gaoDean/eink/README.md

Screenshot 2026-08-07 at 11 20 23 PM
