gaoDean/eink/sims/led.asc

GREEN: LED; NSCW100
M1: nmos; BSS145
ORANGE: LED; NSCW100
R1: res; {R_val}
R2: res; 1K
R3: res; 100K
R4: res; 1K
V1: voltage; 5
Named nets: 0
.step param R_val list 1 1k 5k 10k 50k 100k
.op
