gaoDean/eink/sims/power path.asc

C1: cap; 4.7µ; V=10 Irms=0 Rser=4 Lser=0 mfg="AVX" pn="TAJB475M010" type="Tantalum"
C2: cap; 22µ; V=16 Irms=0 Rser=1.6 Lser=0 mfg="AVX" pn="TAJC226K016" type="Tantalum"
C3: cap; 1µ; V=16 Irms=0 Rser=11 Lser=0
D1: schottky; MBRS140
M1: pmos; AO3423
R1: res; 100K; tol=1 pwr=0.1
R2: res; 100R
R3: res; 10K; tol=1 pwr=0.1
V1: voltage; 3.7
V2: voltage; PWL(0 0 0.01 5)
Named nets: 0
.tran 0.02
