gaoDean/eink/sims/reverse polarity.asc

M1: pmos; AO6407
R1: res; 100k
R2: res; 100R
V1: voltage; PWL(0 4.2 2 -4.2)
Named nets: 0
.tran 2
