gaoDean/eink/eink.kicad_pcb

## KiCad design eink.kicad_pcb (2026-08-09)

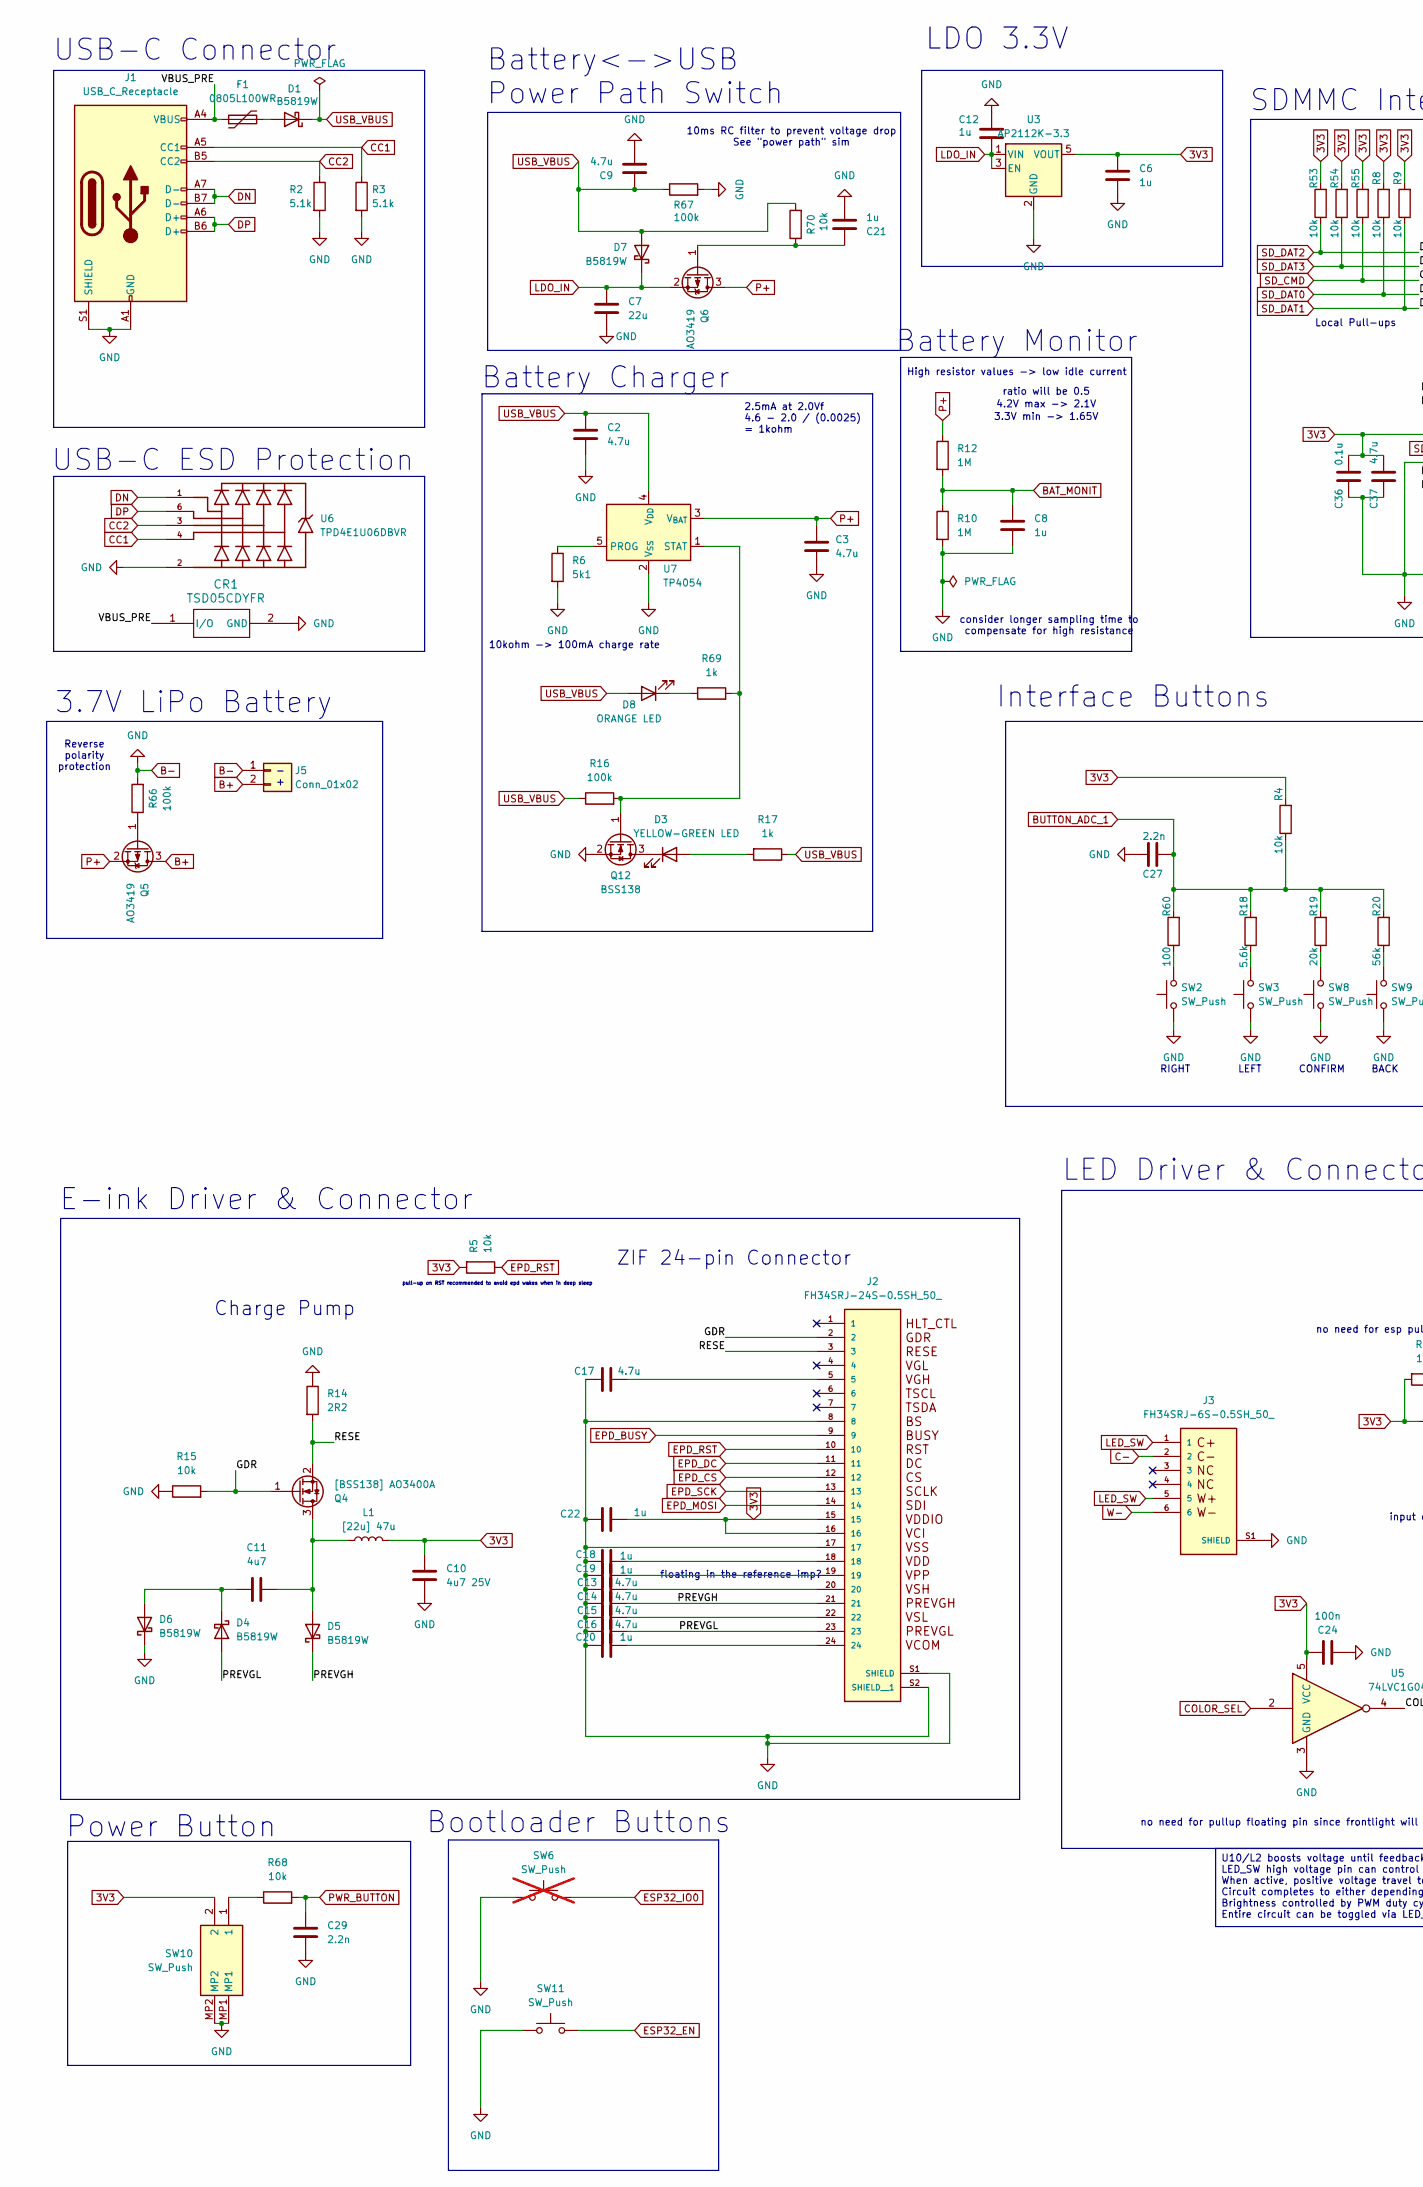
[picture p1: schematic eink.kicad_sch, part in row 1, column 1]

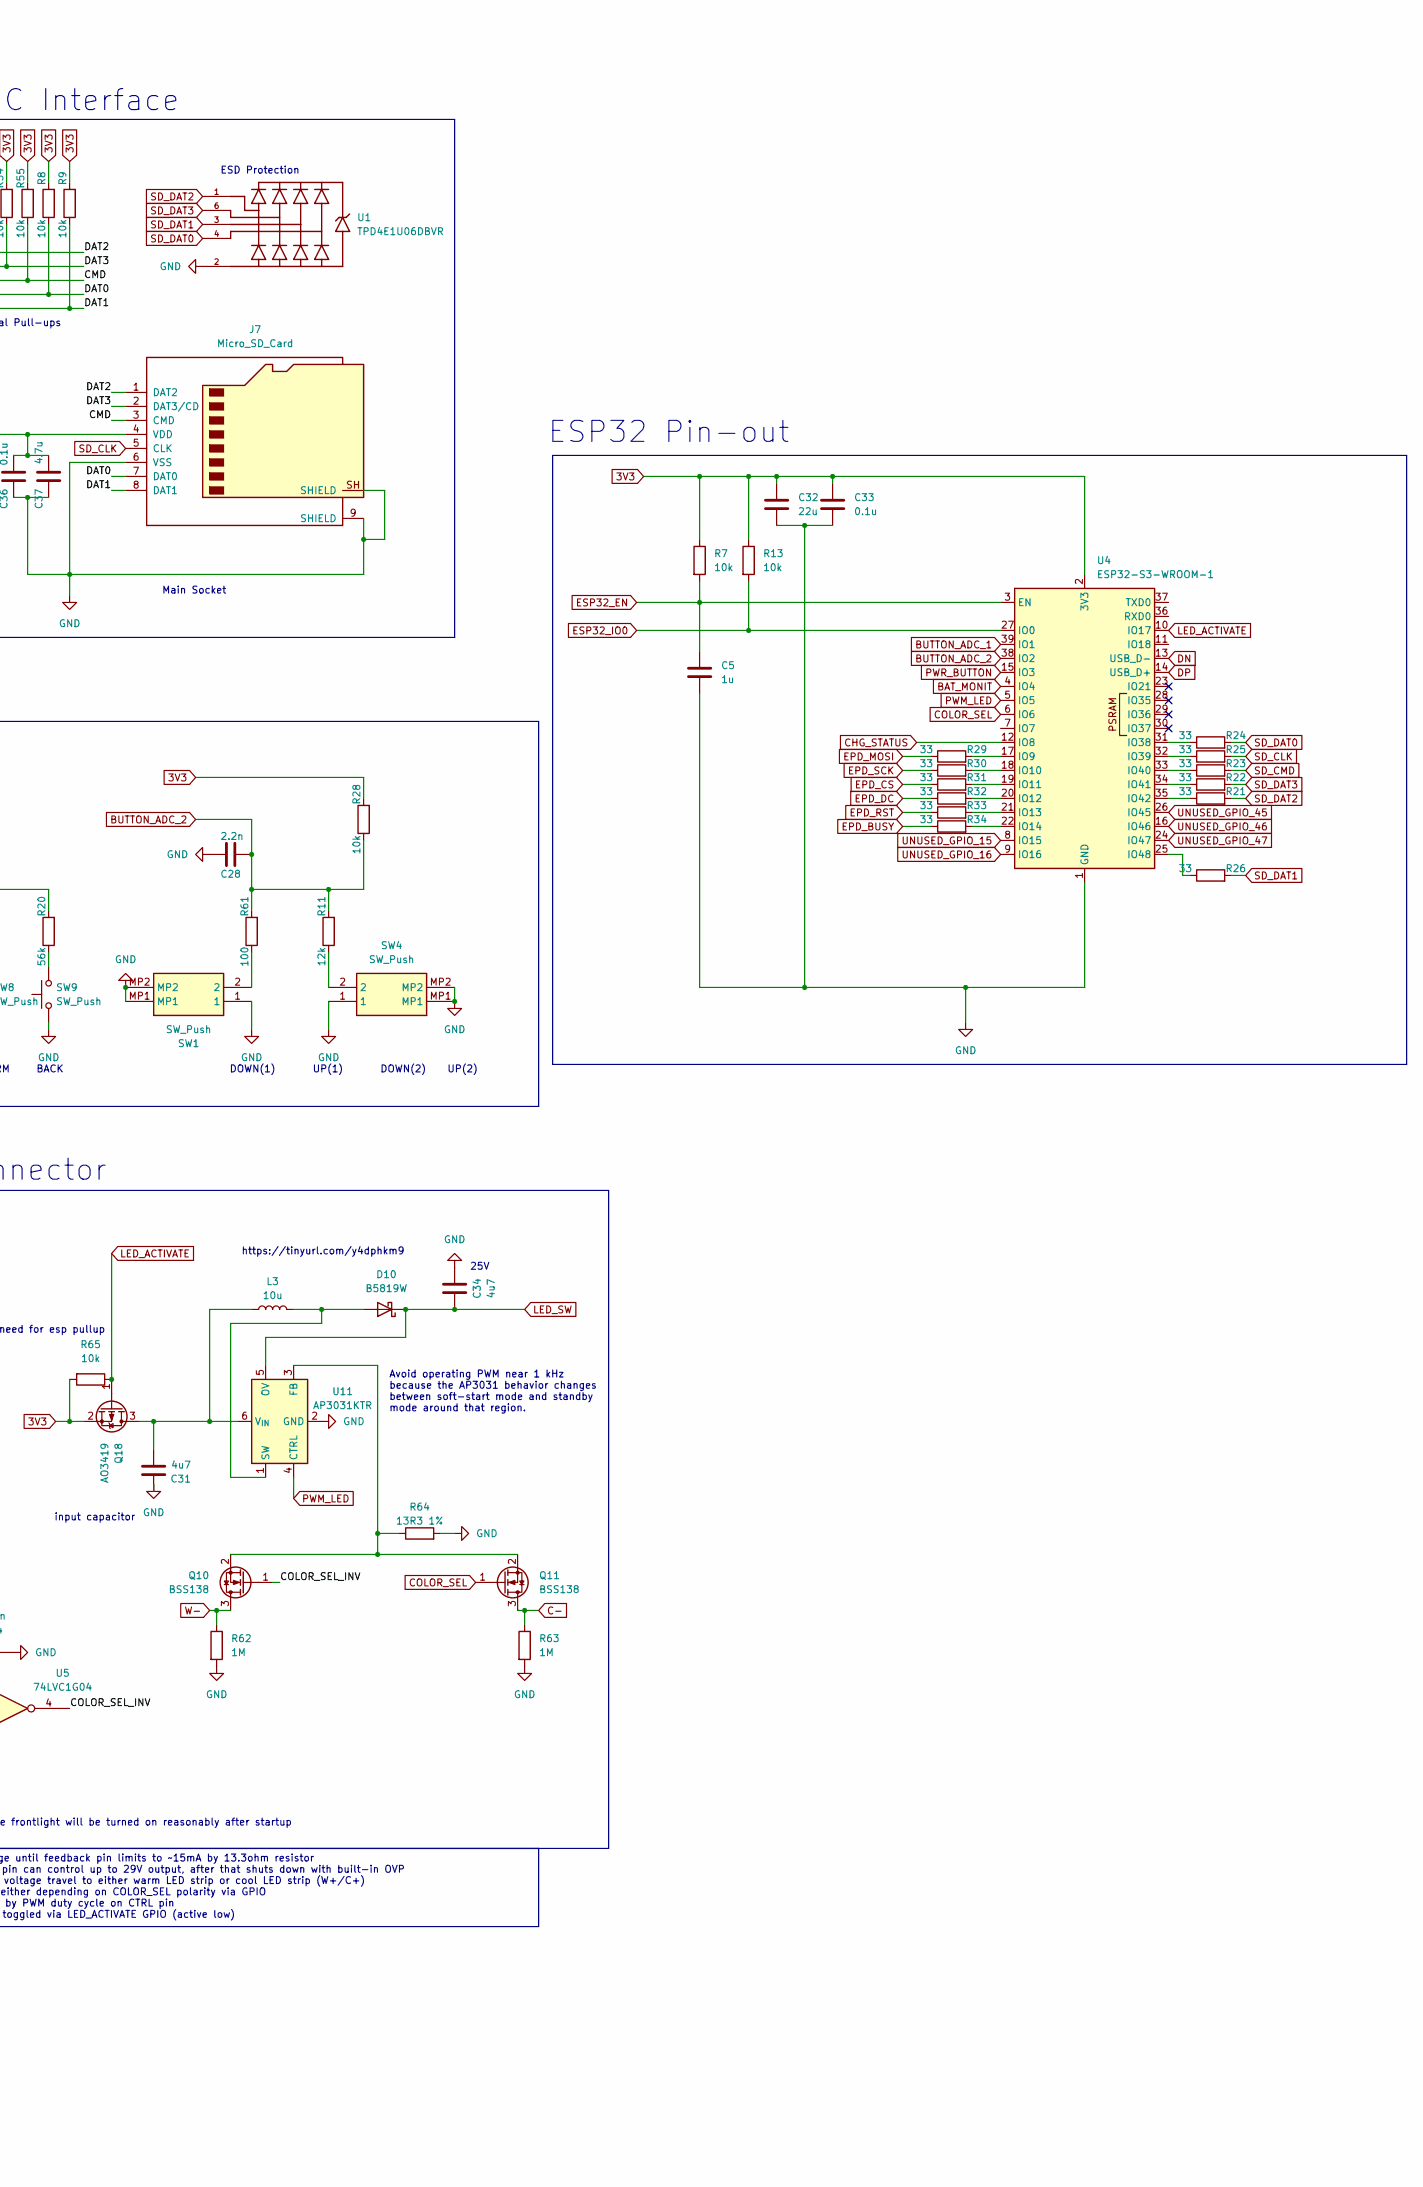
[picture p2: schematic eink.kicad_sch, part in row 1, column 2]

Parts:
C2, C3, C9, C13, C14, C15, C16, C17, C37: 4.7u; C_0805_2012Metric_Pad1.18x1.45mm_HandSolder
C5, C6, C8, C12, C18, C19, C20, C21, C22: 1u; C_0805_2012Metric_Pad1.18x1.45mm_HandSolder
C7, C32: 22u; C_0805_2012Metric_Pad1.18x1.45mm_HandSolder
C10: 4u7 25V; C_0805_2012Metric_Pad1.18x1.45mm_HandSolder
C11, C31, C34: 4u7; C_0805_2012Metric_Pad1.18x1.45mm_HandSolder
C24: 100n; C_0805_2012Metric_Pad1.18x1.45mm_HandSolder
C27, C28, C29: 2.2n; C_0805_2012Metric_Pad1.18x1.45mm_HandSolder
C33, C36: 0.1u; C_0805_2012Metric_Pad1.18x1.45mm_HandSolder
CR1: TSD05CDYFR; D_SOD-323_HandSoldering
D1, D4, D5, D6, D7, D10: B5819W; D_SOD-123
D3: YELLOW-GREEN LED; LED_0805_2012Metric_Pad1.15x1.40mm_HandSolder
D8: ORANGE LED; LED_0805_2012Metric_Pad1.15x1.40mm_HandSolder
F1: 0805L100WR; Fuse_0805_2012Metric_Pad1.15x1.40mm_HandSolder
J1: USB_C_Receptacle; USB_C_Receptacle_TYPE-C-16P-CB1-6-073
J2: FH34SRJ-24S-0.5SH_50_; HRS_FH34SRJ-24S-0.5SH_50_
J3: FH34SRJ-6S-0.5SH_50_; HRS_FH34SRJ-6S-0.5SH_50_; DigiKey_Part_Number H125773CT-ND
J5: Conn_01x02; Battery pads
J7: Micro_SD_Card; microSD_HC_Hirose_DM3AT-SF-PEJM5
L1: [22u] 47u; IND_SRN3010C-100M
L3: 10u; IND_SRN3010C-100M
Q4: [BSS138] AO3400A; SOT-23
Q5, Q6, Q18: AO3419; SOT-23_Handsoldering
Q10, Q11, Q12: BSS138; SOT-23
R2, R3: 5.1k; R_0805_2012Metric_Pad1.20x1.40mm_HandSolder
R4, R5, R7, R8, R9, R13, R15, R28, R53, R54, R55, R65, R68, R70: 10k; R_0805_2012Metric_Pad1.20x1.40mm_HandSolder
R6: 5k1; R_0805_2012Metric_Pad1.20x1.40mm_HandSolder
R10, R12, R62, R63: 1M; R_0805_2012Metric_Pad1.20x1.40mm_HandSolder
R11: 12k; R_0805_2012Metric_Pad1.20x1.40mm_HandSolder
R14: 2R2; R_0805_2012Metric_Pad1.20x1.40mm_HandSolder
R16, R66, R67: 100k; R_0805_2012Metric_Pad1.20x1.40mm_HandSolder
R17, R69: 1k; R_0805_2012Metric_Pad1.20x1.40mm_HandSolder
R18: 5.6k; R_0805_2012Metric_Pad1.20x1.40mm_HandSolder
R19: 20k; R_0805_2012Metric_Pad1.20x1.40mm_HandSolder
R20: 56k; R_0805_2012Metric_Pad1.20x1.40mm_HandSolder
R21, R22, R23, R24, R25, R26, R29, R30, R31, R32, R33, R34: 33; R_0805_2012Metric_Pad1.20x1.40mm_HandSolder
R60, R61: 100; R_0805_2012Metric_Pad1.20x1.40mm_HandSolder
R64: 13R3 1%; R_0805_2012Metric_Pad1.20x1.40mm_HandSolder
SW1, SW4, SW10: SW_Push; SKSNLAE010; Mouser Part Number 688-SKSNLAE010
SW2, SW3, SW8, SW9: SW_Push; SKQGABE010_ALPS_Reverse
SW6: SW_Push; TestPoint_Bridge_Pitch2.54mm_Drill1.0mm; not fitted
SW11: SW_Push; TestPoint_Bridge_Pitch2.54mm_Drill1.0mm
U1, U6: TPD4E1U06DBVR; SOT-23-6_Handsoldering; PARTREV D; DigiKey_Part_Number 296-35965-1-ND
U3: AP2112K-3.3; SOT-23-5_HandSoldering
U4: ESP32-S3-WROOM-1
U5: 74LVC1G04; SOT-23-5_HandSoldering
U7: TP4054; SOT-23-5
U11: AP3031KTR; SOT-23-6_Handsoldering

Connections:
3V3: C6.1, C10.2, C22.2, C24.1, C32.1, C33.1, C36.2, C37.2, J2.15, J2.16, J7.4 (VDD), L1.2, Q18.2 (S), R4.2, R5.2, R7.1, R8.2, R9.2, R13.1, R28.2, R53.2, R54.2, R55.2, R65.2, SW10.2, U3.5 (VOUT), U4.2 (3V3), U5.5 (VCC)
/COLOR_SEL_INV: Q10.1 (G), U5.4
/GDR: J2.2, Q4.1 (G), R15.2
/PREVGH: C14.2, D5.1 (K), J2.21
/PREVGL: C16.2, D4.2 (A), J2.23
/RESE: J2.3, Q4.2 (S), R14.2
/VBUS_PRE: CR1.1 (I/O), F1.1, J1.A4 (VBUS), J1.A9 (VBUS), J1.B4 (VBUS), J1.B9 (VBUS)
B+: J5.2, Q5.3 (D)
B-: C2.2, C3.2, C5.2, C6.2, C7.2, C8.2, C9.2, C10.1, C12.2, C13.1, C14.1, C15.1, C16.1, C17.1, C18.1, C19.1, C20.1, C21.2, C22.1, C24.2, C27.1, C28.1, C29.2, C31.1, C32.2, C33.2, C34.1, C36.1, C37.1, CR1.2 (GND), D6.1 (K), J1.A1 (GND), J1.A12 (GND), J1.B1 (GND), J1.B12 (GND), J1.S1 (SHIELD), J2.8, J2.17, J2.S1 (SHIELD), J2.S2 (SHIELD__1), J3.S1 (SHIELD), J3.S2 (SHIELD), J5.1, J7.6 (VSS), J7.9 (SHIELD), J7.SH (SHIELD), Q12.2 (S), R2.2, R3.2, R6.2, R10.2, R14.1, R15.1, R62.2, R63.2, R64.2, R66.2, R67.2, SW1.1, SW1.MP1, SW1.MP2, SW2.1, SW3.1, SW4.1, SW4.MP1, SW4.MP2, SW6.1, SW8.1, SW9.1, SW10.MP1, SW10.MP2, SW11.1, U1.2, U3.2 (GND), U4.1 (GND), U4.40 (GND), U4.41 (GND), U5.3 (GND), U6.2, U7.2 (V_{SS}), U11.2 (GND)
BAT_MONIT: C8.1, R10.1, R12.2, U4.4 (IO4)
BUTTON_ADC_1: C27.2, R4.1, R18.2, R19.2, R20.2, R60.2, U4.39 (IO1)
BUTTON_ADC_2: C28.2, R11.2, R28.1, R61.2, U4.38 (IO2)
C-: J3.2, Q11.3 (D), R63.1
CC1: J1.A5 (CC1), R3.1, U6.4
CC2: J1.B5 (CC2), R2.1, U6.3
CHG_STATUS: U4.12 (IO8)
COLOR_SEL: Q11.1 (G), U4.6 (IO6), U5.2
DN: J1.A7 (D-), J1.B7 (D-), U4.13 (USB_D-), U6.1
DP: J1.A6 (D+), J1.B6 (D+), U4.14 (USB_D+), U6.6
EPD_BUSY: J2.9, R34.1
EPD_CS: J2.12, R31.1
EPD_DC: J2.11, R32.1
EPD_MOSI: J2.14, R29.1
EPD_RST: J2.10, R5.1, R33.1
EPD_SCK: J2.13, R30.1
ESP32_EN: C5.1, R7.2, SW11.2, U4.3 (EN)
ESP32_IO0: R13.2, SW6.2, U4.27 (IO0)
LDO_IN: C7.1, C12.1, D7.1 (K), Q6.2 (S), U3.1 (VIN), U3.3 (EN)
LED_ACTIVATE: Q18.1 (G), R65.1, U4.10 (IO17)
LED_SW: C34.2, D10.1 (K), J3.1, J3.5, U11.5 (OV)
unnamed: C13.2, J2.20
unnamed: C15.2, J2.22
unnamed: C17.2, J2.5
unnamed: C18.2, J2.18
unnamed: C19.2, J2.19
unnamed: C20.2, J2.24
unnamed: D1.2 (A), F1.2
unnamed: D3.2 (A), R17.2
unnamed: D3.1 (K), Q12.3 (D)
unnamed: C11.1, D4.1 (K), D6.2 (A)
unnamed: C11.2, D5.2 (A), L1.1, Q4.3 (D)
unnamed: D8.1 (K), R69.1
unnamed: D10.2 (A), L3.2, U11.1 (SW)
unnamed: Q5.1 (G), R66.1
unnamed: C21.1, Q6.1 (G), R70.1
unnamed: Q10.2 (S), Q11.2 (S), R64.1, U11.3 (FB)
unnamed: Q12.1 (G), R16.2, R69.2, U7.1 (STAT)
unnamed: C31.2, L3.1, Q18.3 (D), U11.6 (V_{IN})
unnamed: R11.1, SW4.2
unnamed: R18.1, SW3.2
unnamed: R19.1, SW8.2
unnamed: R20.1, SW9.2
unnamed: R60.1, SW2.2
unnamed: R61.1, SW1.2
unnamed: R68.1, SW10.1
unnamed: R29.2, U4.17 (IO9)
unnamed: R30.2, U4.18 (IO10)
unnamed: R31.2, U4.19 (IO11)
unnamed: R32.2, U4.20 (IO12)
unnamed: R33.2, U4.21 (IO13)
unnamed: R34.2, U4.22 (IO14)
unnamed: R24.1, U4.31 (IO38)
unnamed: R25.1, U4.32 (IO39)
unnamed: R23.1, U4.33 (IO40)
unnamed: R22.1, U4.34 (IO41)
unnamed: R21.1, U4.35 (IO42)
unnamed: R26.1, U4.25 (IO48)
unnamed: R6.1, U7.5 (PROG)
P+: C3.1, Q5.2 (S), Q6.3 (D), R12.1, U7.3 (V_{BAT})
PWM_LED: U4.5 (IO5), U11.4 (CTRL)
PWR_BUTTON: C29.1, R68.2, U4.15 (IO3)
SD_CLK: J7.5 (CLK), R25.2
SD_CMD: J7.3 (CMD), R23.2, R55.1
SD_DAT0: J7.7 (DAT0), R8.1, R24.2, U1.4
SD_DAT1: J7.8 (DAT1), R9.1, R26.2, U1.3
SD_DAT2: J7.1 (DAT2), R21.2, R53.1, U1.1
SD_DAT3: J7.2 (DAT3/CD), R22.2, R54.1, U1.6
UNUSED_GPIO_15: U4.8 (IO15)
UNUSED_GPIO_16: U4.9 (IO16)
UNUSED_GPIO_45: U4.26 (IO45)
UNUSED_GPIO_46: U4.16 (IO46)
UNUSED_GPIO_47: U4.24 (IO47)
USB_VBUS: C2.1, C9.1, D1.1 (K), D7.2 (A), D8.2 (A), R16.1, R17.1, R67.1, R70.2, U7.4 (V_{DD})
W-: J3.6, Q10.3 (D), R62.1

Notes on the sheet:
ratio will be 0.5
SDMMC Interface
2.5mA at 2.0Vf 4.6 - 2.0 / (0.0025) = 1kohm
Battery<->USB Power Path Switch
RIGHT LEFT CONFIRM BACK
no need for pullup floating pin since frontlight will be turned on reasonably after startup
3.7V LiPo Battery
input capacitor
Charge Pump
LED Driver & Connector
Interface Buttons
Avoid operating PWM near 1 kHz because the AP3031 behavior changes between soft-start mode and standby mode around that region.
3.3V min -> 1.65V
- +
25V
pull-up on RST recommended to avoid epd wakes when in deep sleep
E-ink Driver & Connector
ESD Protection
Battery Charger
consider longer sampling time to compensate for high resistance
10ms RC filter to prevent voltage drop See "power path" sim
ESP32 Pin-out
Reverse polarity protection
4.2V max -> 2.1V
ZIF 24-pin Connector
Local Pull-ups
DOWN(1) UP(1) DOWN(2) UP(2)
https://tinyurl.com/y4dphkm9
LDO 3.3V
Power Button
High resistor values -> low idle current
Battery Monitor
USB-C ESD Protection
USB-C Connector
Bootloader Buttons
10kohm -> 100mA charge rate
Main Socket
floating in the reference imp?
no need for esp pullup
U10/L2 boosts voltage until feedback pin limits to ~15mA by 13.3ohm resistor LED_SW high voltage pin can control up to 29V output, after that shuts down with built-in OVP When active, positive voltage travel to either warm LED strip or cool LED strip (W+/C+) Circuit completes to either depending on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

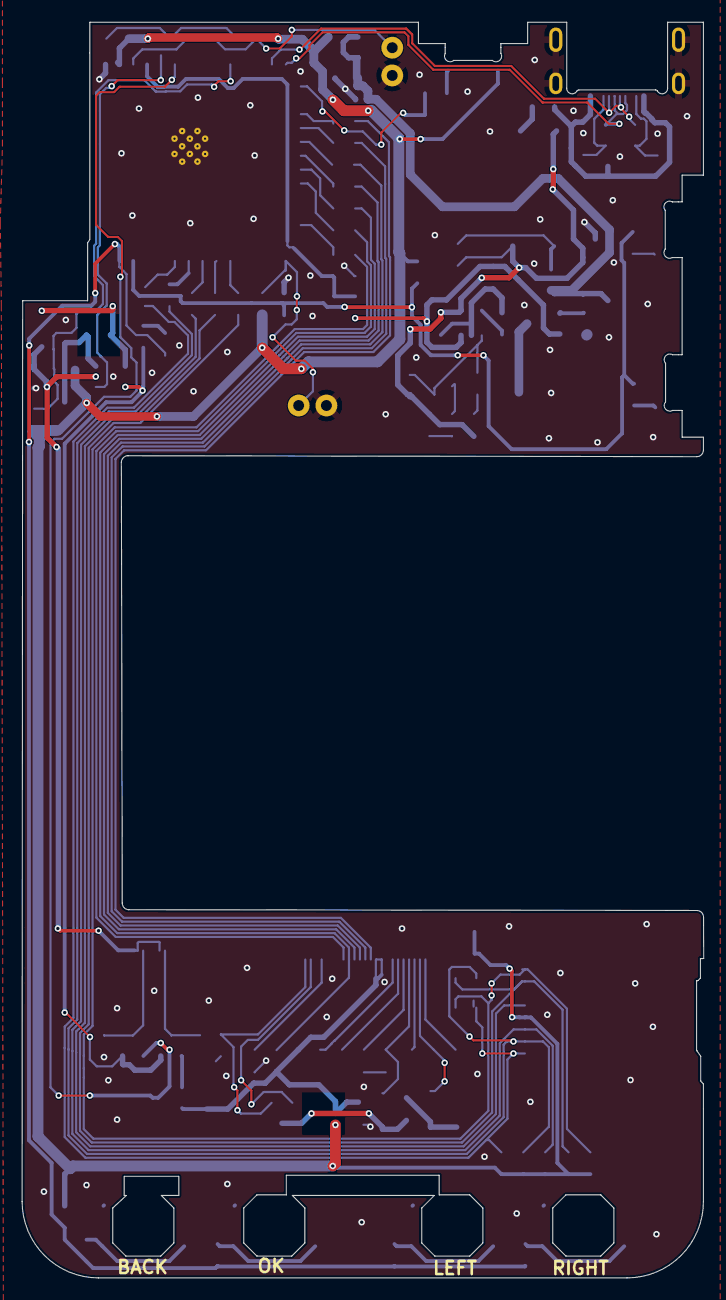
[picture p3: board eink.kicad_pcb from above]

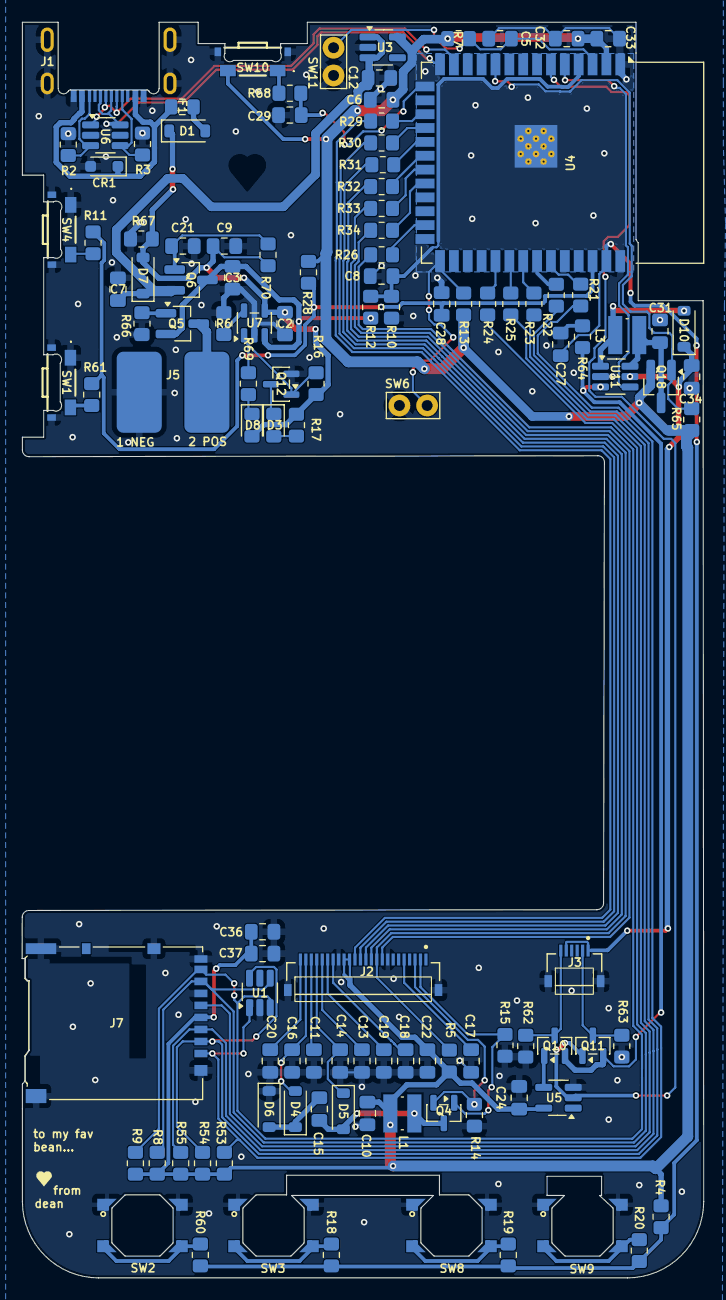
[picture p4: board eink.kicad_pcb from below]

Board: 2 copper layers, 62.4 x 115.0 mm, 116 parts (116 on the bottom side), 78 nets.
