gaoDean/eink/(commit log)

2026-06-13 first draft for 1.0
    [minRead_pcb.kicad_pcb, minRead_pcb.kicad_sch]
2026-06-18 update silkscreen
    [de-link just parts.ods, minRead_pcb.kicad_pcb, minRead_pcb.kicad_sch]
2026-06-23 revised layout for emi/emc
    [de-link just parts.ods, minRead_pcb.kicad_pcb, minRead_pcb.kicad_sch]
2026-06-24 added fuse changed mbr to b5819w for current rating increase changed r38 to reduce leakage spiffied up silkscreen
    [minRead_pcb.kicad_sch]
2026-06-24 updated parts sheet
    [de-link just parts.ods]
2026-07-07 shaved down dev header size
    [minRead_pcb.kicad_sch]
2026-07-30 revised schematic/layout and LED driver sim; drop tracked sim raw output
    [minRead_pcb.kicad_pcb, minRead_pcb.kicad_sch]
2026-07-30 Make project self-contained + repo hygiene
    - add project-local sym-lib-table and fp-lib-table so custom symbol/
    footprint libraries travel with the repo (all paths via ${KIPRJMOD});
    converts previously machine-absolute entries
    - vendor Battery_Management.kicad_sym (DW01A/MCP73832) which lived only
    in the KiCad install dir and would not survive a clone/reinstall
    - fix MJTP1117 3D-model path: bare "MJTP1117.stp" -> ${KIPRJMOD} path
    - add .gitattributes forcing LF so autocrlf doesn't create phantom diffs
    - stop tracking per-user state (.kicad_prl) and regenerated fp-info-cache
    [minRead_pcb.kicad_pcb]
2026-07-31 updated schematic with new LED circuit, new power path, new protections, esd fix ups, etc. resetting layout, will do later
    [minRead_pcb.kicad_pcb, minRead_pcb.kicad_sch]
2026-08-02 simplify led driver; assume frontlight always connected + other circuit component changes
    [minRead_pcb.kicad_sch]
2026-08-02 remove left buttons, begin simplifying charge circuit
    [minRead_pcb.kicad_sch]
2026-08-02 charge circuit removed overcharge protection
    [minRead_pcb.kicad_sch]
2026-08-02 simplify reverse polarity circuit
    [minRead_pcb.kicad_sch]
2026-08-02 remove external peripheral port
    [minRead_pcb.kicad_sch]
2026-08-02 general cleanup and notation
    [minRead_pcb.kicad_sch]
2026-08-02 larger battery cutout
    [minRead_pcb.kicad_pcb]
2026-08-02 remove second set of buttons
    [minRead_pcb.kicad_sch]
2026-08-02 match screen size to pcb size
    [minRead_pcb.kicad_pcb]
2026-08-02 add back bottom buttons
    [minRead_pcb.kicad_pcb, minRead_pcb.kicad_sch]
2026-08-02 finish adding buttons
    [minRead_pcb.kicad_pcb]
2026-08-02 general setup prep for routing
    [minRead_pcb.kicad_pcb]
2026-08-02 add specific netclasses
    [minRead_pcb.kicad_pcb, minRead_pcb.kicad_sch]
2026-08-03 simplify power path circuit design
    [minRead_pcb.kicad_sch]
2026-08-03 implement charge pump
    [minRead_pcb.kicad_pcb, minRead_pcb.kicad_sch]
2026-08-03 charge pump in place
    [minRead_pcb.kicad_pcb]
2026-08-03 light bar circuit mostly routed
    [minRead_pcb.kicad_pcb, minRead_pcb.kicad_sch]
2026-08-03 reverse mount buttons
    [minRead_pcb.kicad_pcb, minRead_pcb.kicad_sch]
2026-08-04 proper port positioning
    [minRead_pcb.kicad_pcb]
2026-08-04 mostly routed
    [minRead_pcb.kicad_pcb]
2026-08-05 switch buttons to mid mount
    [minRead_pcb.kicad_pcb, minRead_pcb.kicad_sch]
2026-08-05 pre drs
    [minRead_pcb.kicad_pcb, minRead_pcb.kicad_sch]
2026-08-05 fix some drc
    [minRead_pcb.kicad_pcb]
2026-08-05 switch to 5k1 prog
    [minRead_pcb.kicad_pcb, minRead_pcb.kicad_sch]
2026-08-07 mostly fin, some edge cut changes
    [minRead_pcb.kicad_pcb, minRead_pcb.kicad_sch]
2026-08-08 final touches, inverter
    [minRead_pcb.kicad_pcb, minRead_pcb.kicad_sch]
2026-08-08 directory stuff
    [minRead_pcb.csv, minRead_pcb_V2.xlsx]
